mattclarkdotnet/amp_controller/schematic.pdf

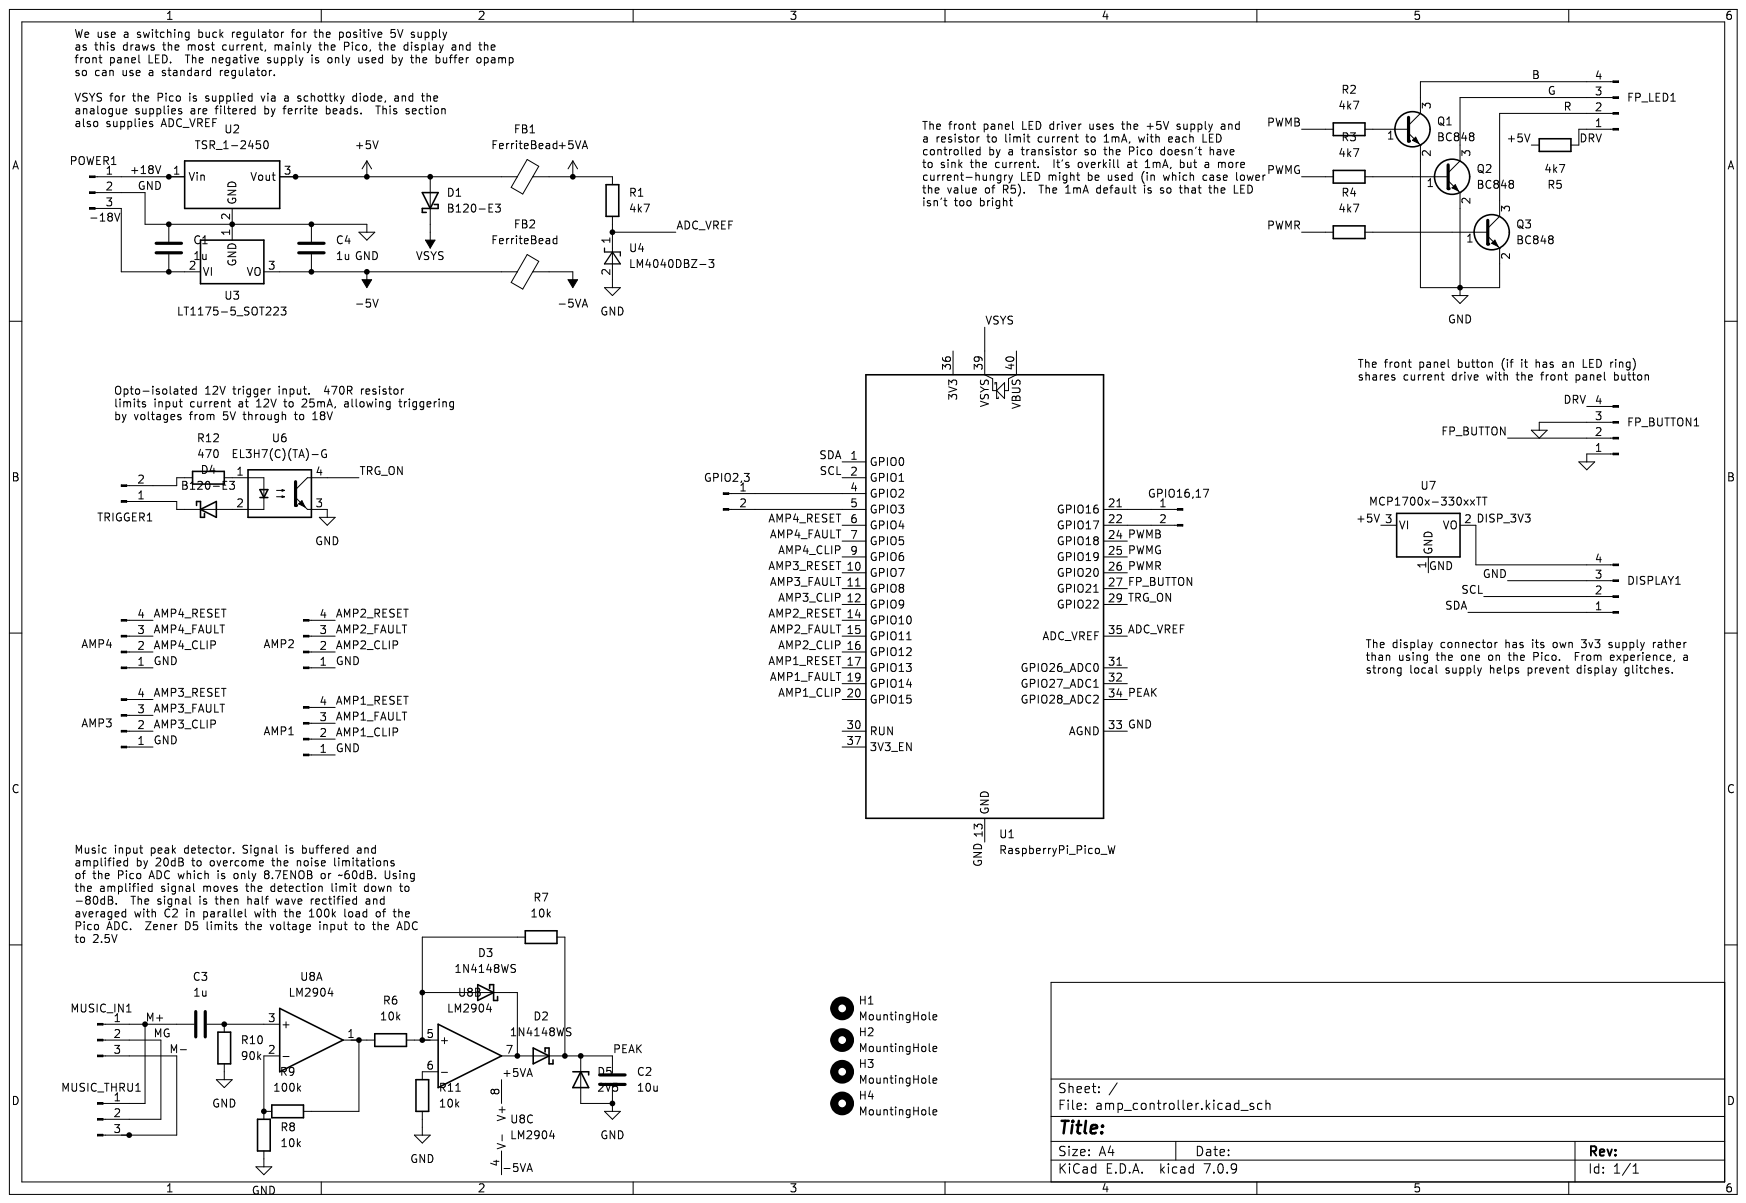
[picture p1: page 1]
