mattclarkdotnet/amp_controller/amp_controller.kicad_pcb

## KiCad design amp_controller.kicad_pcb (2024-06-08)

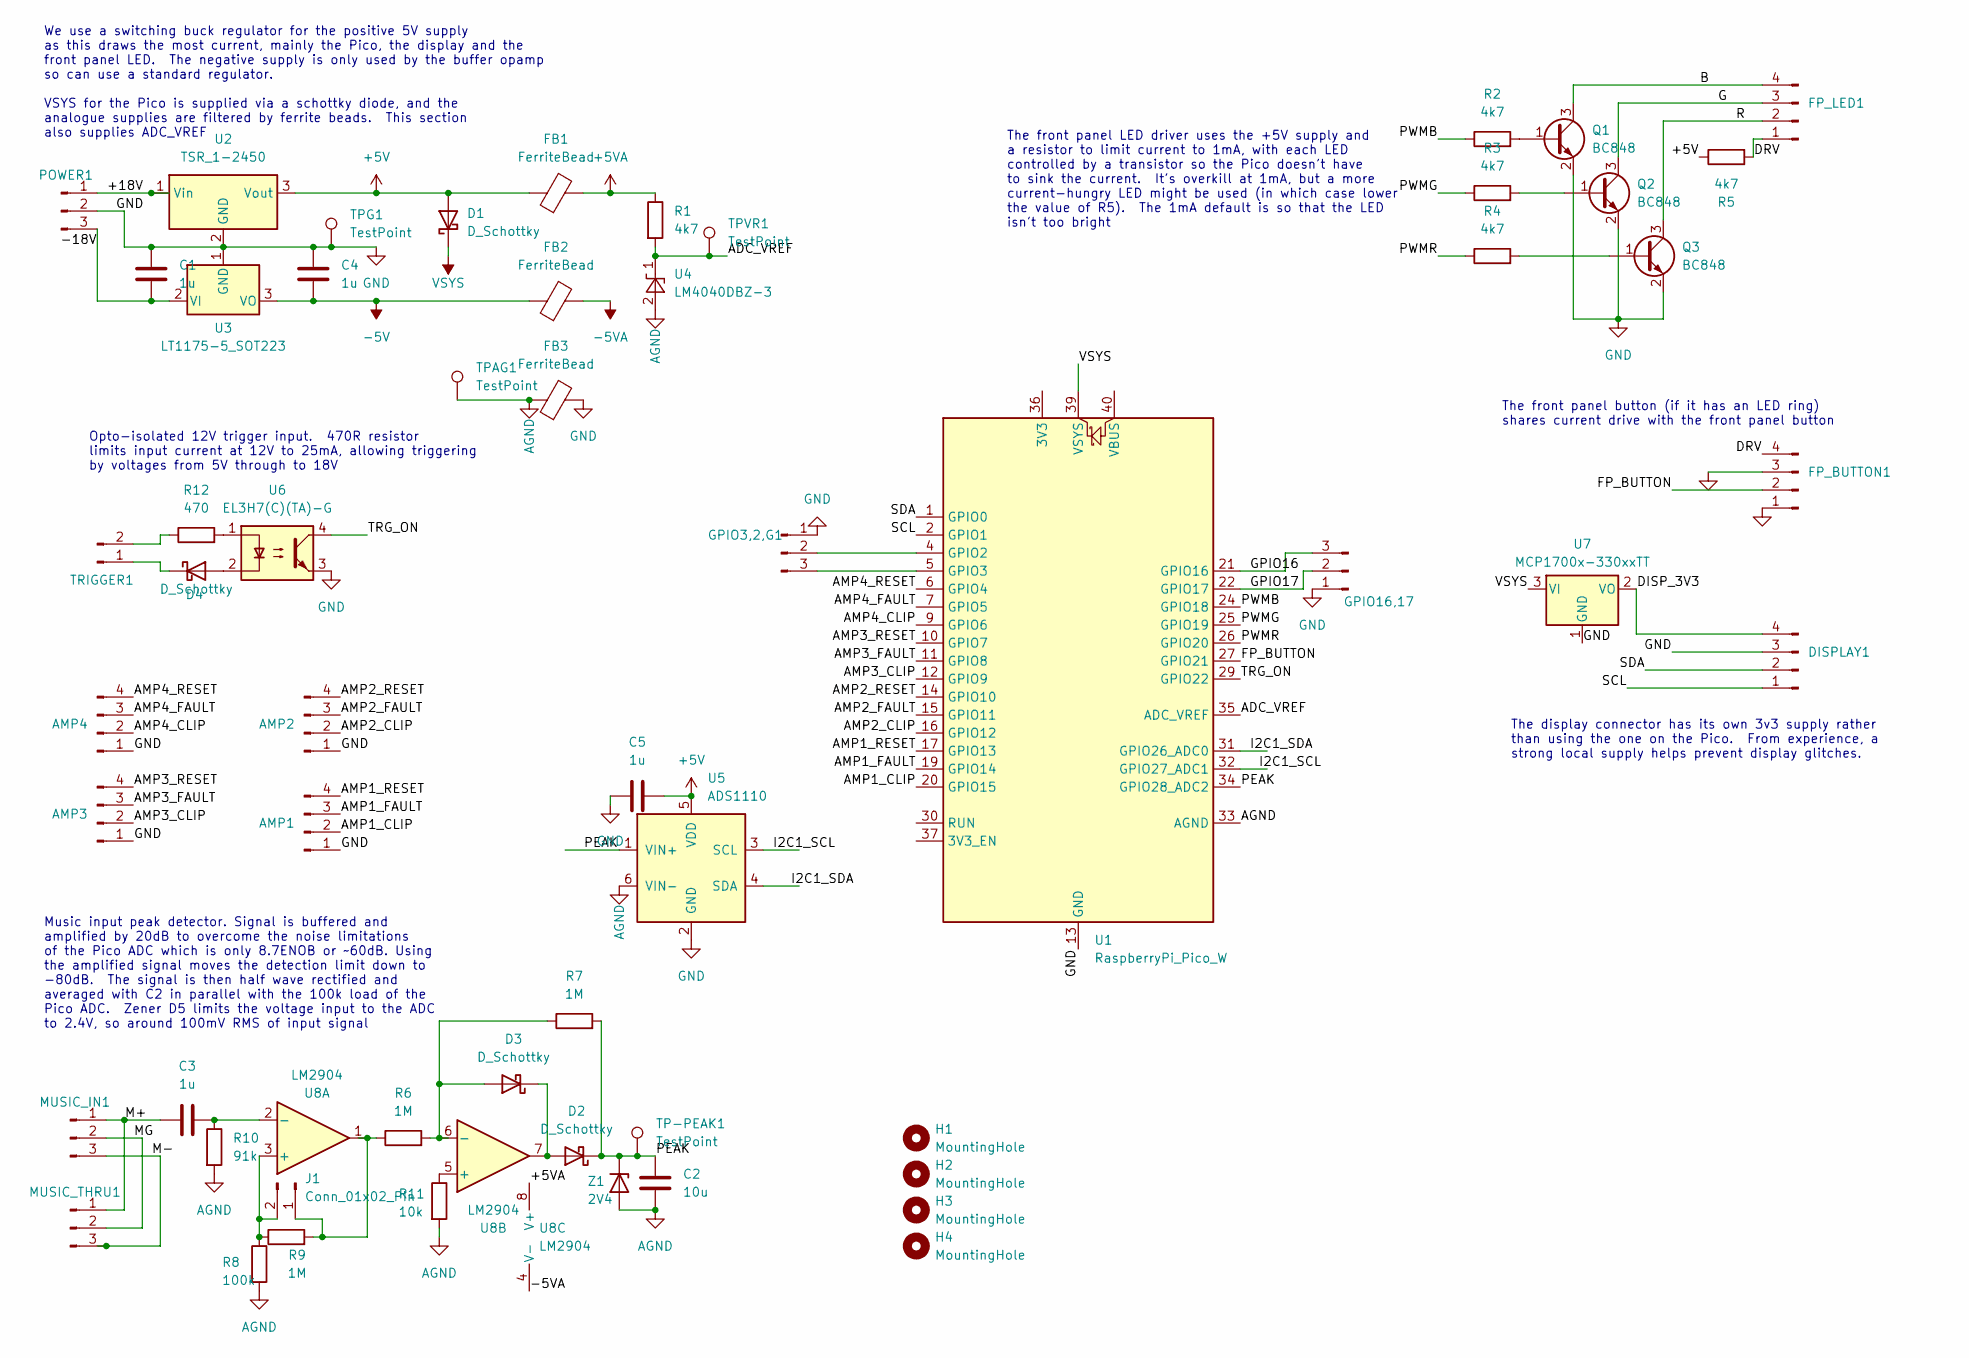
[picture p2: schematic amp_controller.kicad_sch]

Parts:
AMP1, AMP2, AMP3, AMP4: Conn_01x04_Pin; JST_EH_B4B-EH-A_1x04_P2.50mm_Vertical
C1, C3, C4, C5: 1u; C_0805_2012Metric; LCSC C28323
C2: 10u; C_0805_2012Metric; LCSC C440198
D1, D2, D3, D4: D_Schottky; D_SOD-523; LCSC C145179
DISPLAY1: Conn_01x04_Pin; JST_EH_B4B-EH-A_1x04_P2.50mm_Vertical
FB1, FB2, FB3: FerriteBead; L_0805_2012Metric; LCSC C1015
FP_BUTTON1: Conn_01x04_Pin; JST_EH_B4B-EH-A_1x04_P2.50mm_Vertical
FP_LED1: Conn_01x04_Pin; JST_EH_B4B-EH-A_1x04_P2.50mm_Vertical
GPIO3,2,G1, GPIO16,17: Conn_01x02_Pin; PinHeader_1x03_P2.54mm_Vertical
H1, H2, H3, H4: MountingHole; MountingHole_3.2mm_M3
J1: Conn_01x02_Pin; PinHeader_1x02_P2.54mm_Vertical
MUSIC_IN1: Conn_01x03_Pin; JST_EH_B3B-EH-A_1x03_P2.50mm_Vertical
MUSIC_THRU1: Conn_01x03_Pin; JST_EH_B3B-EH-A_1x03_P2.50mm_Vertical
POWER1: Conn_01x03_Pin; TerminalBlock_Phoenix_PT-1,5-3-3.5-H_1x03_P3.50mm_Horizontal
Q1, Q2, Q3: BC848; SOT-723; LCSC C2923360
R1, R2, R3, R4, R5: 4k7; R_0805_2012Metric; LCSC C17673
R6, R7, R9: 1M; R_0805_2012Metric; LCSC C17514
R8: 100k; R_0805_2012Metric; LCSC C149504
R10: 91k; R_0805_2012Metric; LCSC C2930321
R11: 10k; R_0805_2012Metric; LCSC C17414
R12: 470; R_0805_2012Metric; LCSC C17710
TP-PEAK1: TestPoint; TestPoint_THTPad_1.0x1.0mm_Drill0.5mm
TPAG1: TestPoint; TestPoint_THTPad_1.0x1.0mm_Drill0.5mm
TPG1: TestPoint; TestPoint_THTPad_1.0x1.0mm_Drill0.5mm
TPVR1: TestPoint; TestPoint_THTPad_1.0x1.0mm_Drill0.5mm
TRIGGER1: Conn_01x02_Pin; JST_EH_B2B-EH-A_1x02_P2.50mm_Vertical
U1: RaspberryPi_Pico_W; RaspberryPi_Pico_W_SMD
U2: TSR_1-2450; Converter_DCDC_TRACO_TSR-1_THT
U3: LT1175-5_SOT223; SOT-89-3; LCSC C122849
U4: LM4040DBZ-3; SOT-23; LCSC C181416
U5: ADS1110; SOT-23-6; LCSC C16598
U6: EL3H7(C)(TA)-G; SOIC-4_4.55x2.6mm_P1.27mm; LCSC C92243
U7: MCP1700x-330xxTT; SOT-23; LCSC C5446
U8: LM2904; SO-8_3.9x4.9mm_P1.27mm; LCSC C2941725
Z1: 2V4; D_SOD-323; LCSC C268469

Connections:
+5V: C5.2, D1.2 (A), FB1.1, R5.1, U2.3 (Vout), U5.5 (VDD)
+5VA: FB1.2, R1.1, U8.8 (V+)
-5V: C4.2, FB2.1, U3.3 (VO)
-5VA: FB2.2, U8.4 (V-)
/+18V: POWER1.1, U2.1 (Vin)
/-18V: C1.2, POWER1.3, U3.2 (VI)
/ADC_VREF: R1.2, TPVR1.1, U1.35 (ADC_VREF), U4.1 (K)
/AMP1_CLIP: AMP1.2, U1.20 (GPIO15)
/AMP1_FAULT: AMP1.3, U1.19 (GPIO14)
/AMP1_RESET: AMP1.4, U1.17 (GPIO13)
/AMP2_CLIP: AMP2.2, U1.16 (GPIO12)
/AMP2_FAULT: AMP2.3, U1.15 (GPIO11)
/AMP2_RESET: AMP2.4, U1.14 (GPIO10)
/AMP3_CLIP: AMP3.2, U1.12 (GPIO9)
/AMP3_FAULT: AMP3.3, U1.11 (GPIO8)
/AMP3_RESET: AMP3.4, U1.10 (GPIO7)
/AMP4_CLIP: AMP4.2, U1.9 (GPIO6)
/AMP4_FAULT: AMP4.3, U1.7 (GPIO5)
/AMP4_RESET: AMP4.4, U1.6 (GPIO4)
/B: FP_LED1.4, Q1.3 (C)
/DISP_3V3: DISPLAY1.4, U7.2 (VO)
/DRV: FP_BUTTON1.4, FP_LED1.1, R5.2
/FP_BUTTON: FP_BUTTON1.2, U1.27 (GPIO21)
/G: FP_LED1.3, Q2.3 (C)
/GPIO16: GPIO16,17.3, U1.21 (GPIO16)
/GPIO17: GPIO16,17.2, U1.22 (GPIO17)
/I2C1_SCL: U1.32 (GPIO27_ADC1), U5.3 (SCL)
/I2C1_SDA: U1.31 (GPIO26_ADC0), U5.4 (SDA)
/M+: C3.1, MUSIC_IN1.1, MUSIC_THRU1.1
/M-: MUSIC_IN1.3, MUSIC_THRU1.3
/MG: MUSIC_IN1.2, MUSIC_THRU1.2
/PEAK: C2.1, D2.1 (K), R7.2, TP-PEAK1.1, U1.34 (GPIO28_ADC2), U5.1 (VIN+), Z1.1 (K)
/PWMB: R2.1, U1.24 (GPIO18)
/PWMG: R3.1, U1.25 (GPIO19)
/PWMR: R4.1, U1.26 (GPIO20)
/R: FP_LED1.2, Q3.3 (C)
/SCL: DISPLAY1.1, U1.2 (GPIO1)
/SDA: DISPLAY1.2, U1.1 (GPIO0)
/TRG_ON: U1.29 (GPIO22), U6.4
AGND: C2.2, FB3.1, R8.2, R10.2, R11.2, TPAG1.1, U1.33 (AGND), U4.2 (A), U5.6 (VIN-), Z1.2 (A)
GND: AMP1.1, AMP2.1, AMP3.1, AMP4.1, C1.1, C4.1, C5.1, DISPLAY1.3, FB3.2, FP_BUTTON1.1, FP_BUTTON1.3, GPIO3,2,G1.1, GPIO16,17.1, POWER1.2, Q1.2 (E), Q2.2 (E), Q3.2 (E), TPG1.1, U1.3 (GND), U1.8 (GND), U1.13 (GND), U1.18 (GND), U1.23 (GND), U1.28 (GND), U1.38 (GND), U2.2 (GND), U3.1 (GND), U5.2 (GND), U6.3, U7.1 (GND)
unnamed: D2.2 (A), D3.1 (K), U8.7
unnamed: D3.2 (A), R6.2, R7.1, U8.6 (-)
unnamed: D4.2 (A), U6.2
unnamed: D4.1 (K), TRIGGER1.1
unnamed: GPIO3,2,G1.2, U1.4 (GPIO2)
unnamed: GPIO3,2,G1.3, U1.5 (GPIO3)
unnamed: J1.1, R6.1, R9.2, U8.1
unnamed: J1.2, R8.1, R9.1, U8.3 (+)
unnamed: Q1.1 (B), R2.2
unnamed: Q2.1 (B), R3.2
unnamed: Q3.1 (B), R4.2
unnamed: R12.2, U6.1
unnamed: R12.1, TRIGGER1.2
unnamed: C3.2, R10.1, U8.2 (-)
unnamed: R11.1, U8.5 (+)
VSYS: D1.1 (K), U1.39 (VSYS), U7.3 (VI)

Notes on the sheet:
Music input peak detector. Signal is buffered and amplified by 20dB to overcome the noise limitations of the Pico ADC which is only 8.7ENOB or ~60dB. Using the amplified signal moves the detection limit down to -80dB. The signal is then half wave rectified and averaged with C2 in parallel with the 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
The front panel button (if it has an LED ring) shares current drive with the front panel button
Opto-isolated 12V trigger input. 470R resistor limits input current at 12V to 25mA, allowing triggering by voltages from 5V through to 18V
The front panel LED driver uses the +5V supply and a resistor to limit current to 1mA, with each LED controlled by a transistor so the Pico doesn't have to sink the current. It's overkill at 1mA, but a more current-hungry LED might be used (in which case lower the value of R5). The 1mA default is s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
We use a switching buck regulator for the positive 5V supply as this draws the most current, mainly the Pico, the display and the front panel LED. The negative supply is only used by the buffer opamp so can use a standard regulator. VSYS for the Pico is supplied via a schottky diode, and the analog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
The display connector has its own 3v3 supply rather than using the one on the Pico. From experience, a strong local supply helps prevent display glitches.

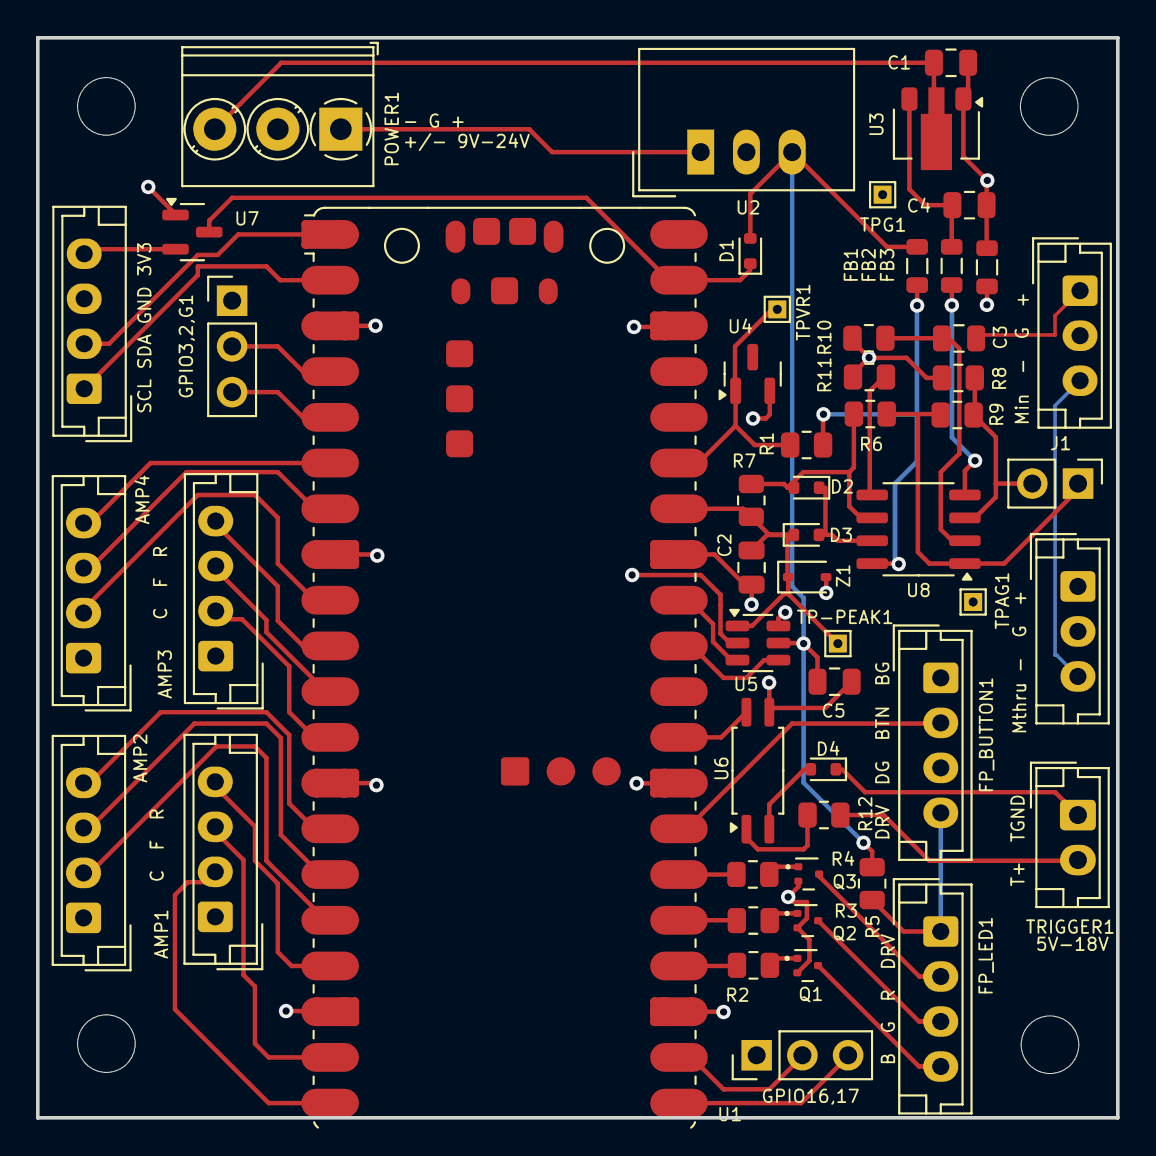
[picture p3: board amp_controller.kicad_pcb from above]

Board: 4 copper layers, 60.0 x 60.0 mm, 58 parts (0 on the bottom side), 57 nets.
