mattclarkdotnet/amp_controller/(commit log)

2024-05-04 passing DRC check, op amp input issue fixed
    [amp_controller.kicad_pcb, amp_controller.kicad_sch]
2024-06-08 tweaked layout and music sense resistors
    [BOM-amp_controller.csv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]
